eshooper2008-cyber/atmoslink/(commit log)

2026-11-03 AtmosLink wireless weather station: transmitter and receiver code, PCBs and README
2026-11-03 Show temperature, high and low on the temperature screen; cover all value ranges; volatile SLIDE; 2 s send interval
